gumbypp/GarageDoor/ios/GarageDoor/door@2x.png

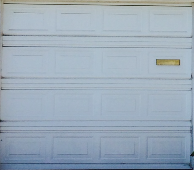
ios/GarageDoor/door@2x.png
