gumbypp/GarageDoor/ios/GarageDoor/house@2x.png

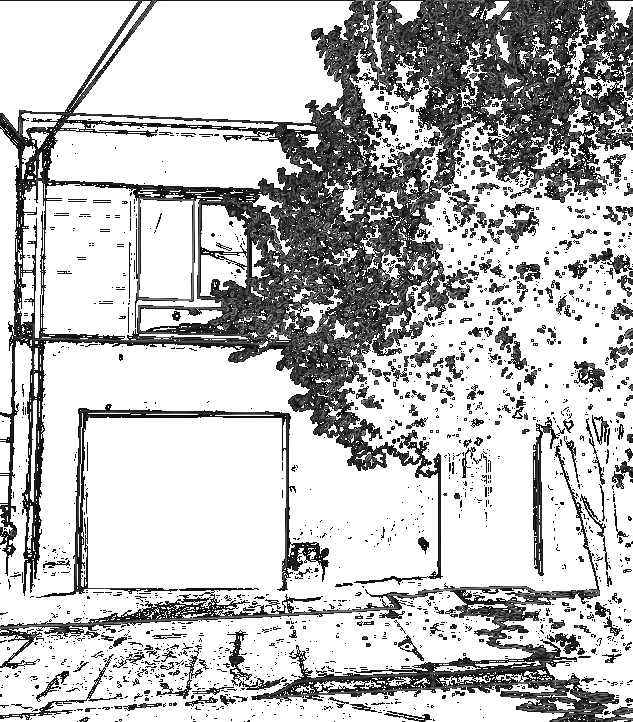
ios/GarageDoor/house@2x.png
