gumbypp/GarageDoor/arduino/sketch/GarageDoor/shared_key.h

//
//  shared_key.h
//  GarageDoor
//
//  Created by Dale Low on 7/17/14.
//  Copyright (c) 2014 gumbypp consulting. All rights reserved.
//

#ifndef GarageDoor_shared_key_h
#define GarageDoor_shared_key_h

// auth
#define kSharedKey                    0xd6db0ba7  // { 0xd6, 0xdb, 0x0b, 0xa7 }

#endif
