gumbypp/GarageDoor/(commit log)

2014-12-14 updated schematic
2016-02-06 App: allow filtering by peripheral name when scanning in case multiple peripherals have the same primary service UUID
2016-02-15 Fix security hole where a key part of zero could always be used if the client knew the shared part of the key; fix a bad assertion; bit of code cleanup.
    [GarageDoor.ino]
2016-02-28 More reliable way of getting the device's friendly name (with iOS 7.x).
